Alanpham-ICdesigner/DOAN1/README.md

# DOAN1
THIẾT KẾ CPU RISC-V RV32I ĐA CHU KỲ THEO KIẾN TRÚC PIPELINE TRÊN KIT FPGA PYNQ-Z2
